jynik/meta-owswaas/README

This is the meta-owswaas Yocto layer, which implements 
Owen Wilson Saying "Wow" as a Service (OWSWaaS).

You can see a demo of it here:
https://twitter.com/utkan0s/status/953669143177424897

This layer currently targets the Raspberry Pi Zero (W), but can easily be adapted
to other platforms. To start, you'll need to add a BTN_GPIO definition in
init-owswaas.bb. You may also need to tweak the alsa-state.bbappend.

If you haven't used Yocto before, you can find a quick intro here:
https://github.com/jynik/ready-set-yocto

Dependencies
============

This layer depends on:

  URI: git://git.yoctoproject.org/poky.git
  layers: meta, meta-poky
  branch: zeus

  URI: https://github.com/agherzan/meta-raspberrypi.git
  layers: meta-raspberrypi
  branch: zeus

  URL: git://git.openembedded.org/meta-openembedded
  layers: meta-oe, meta-multimedia, meta-networking, meta-python, meta-filesystems
  branch: zeus

Patches
=======

Please submit patches as pull requests on Github at:
https://github.com/jynik/meta-owswaas/pulls

Hardware
========

This is a fairly simple setup, and makes for a fun beginner/intermediate hobbyist
electronics project. Information about the hardware components can be found here:

* [Schematic][./doc/owswaas-shield.pdf]
* [Bill of Materials](./doc/BOM.md)
