jynik/meta-owswaas/doc/images/README.md

### OWSWaaS "shield", sans 220 uF bulk capacitor

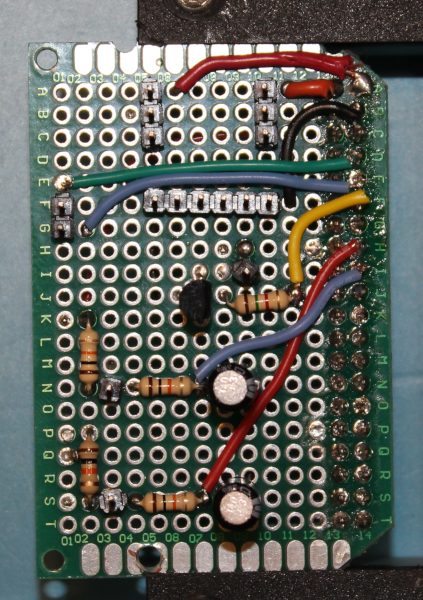
[picture p3: doc/images/shield_top_sans_bulk_cap.png]
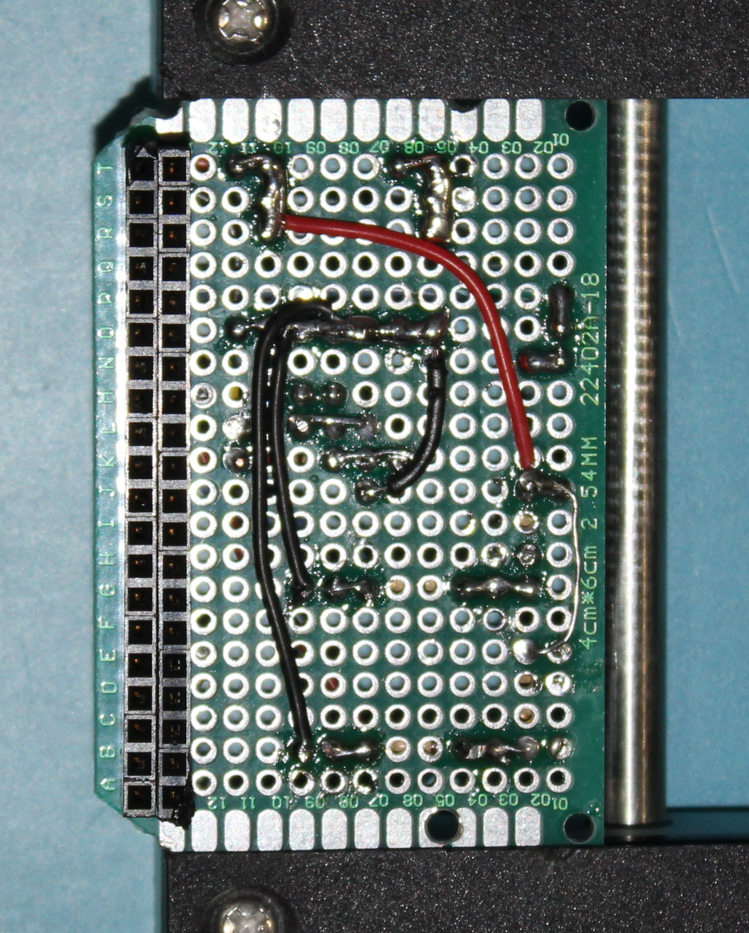
[picture p4: doc/images/shield_bot_sans_bulk_cap.png]


See [owswaas-shield.pdf](../kicad/owswaas-shield.pdf) for the schematic.

### Retrofitting 5 "super bright" LEDs into button dome

Not shown: Replacing the plastic diffuser with one made out of hot glue and green transparent filter paper.



### Testing everything prior to closing it all up

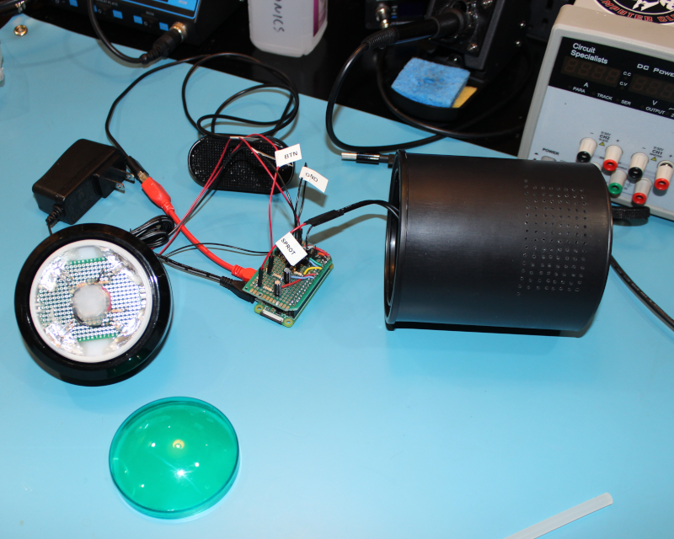
[picture p5: doc/images/assembly-01.png]


### Installing jumpers

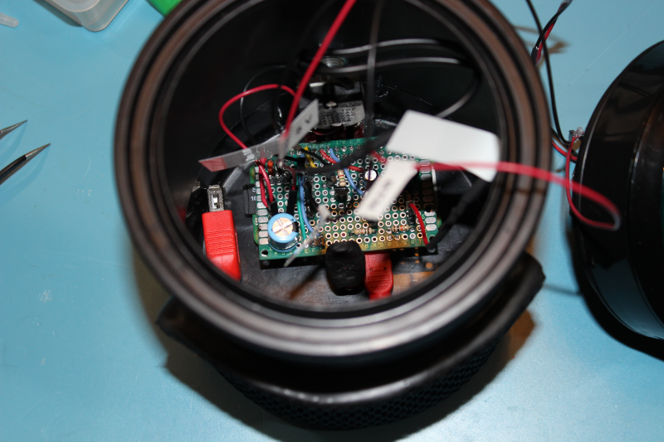
[picture p6: doc/images/assembly-02.png]


### Velcro'ing USB speaker into place

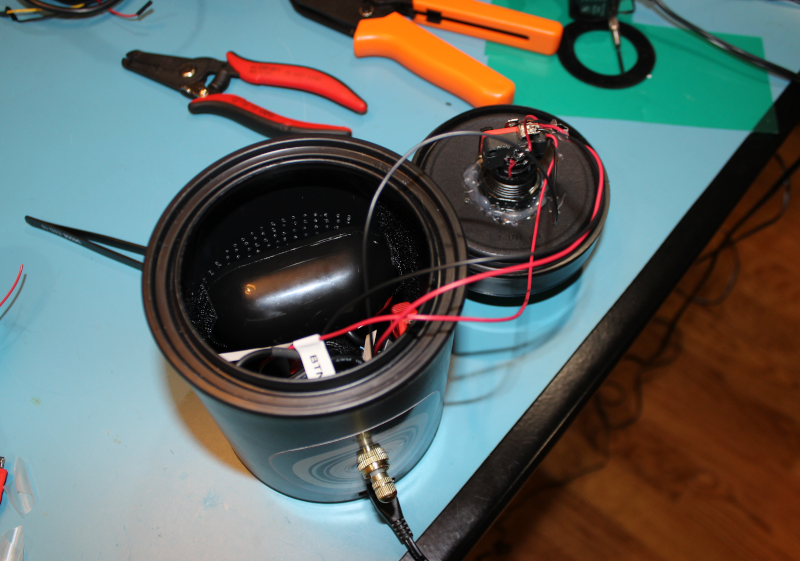
[picture p7: doc/images/assembly-03.png]


### Assembled device, faux speaker front



### Assembled device, rotary switch and USB micro power 
