jynik/meta-owswaas/doc/images/owswaas-jumper-pos.png

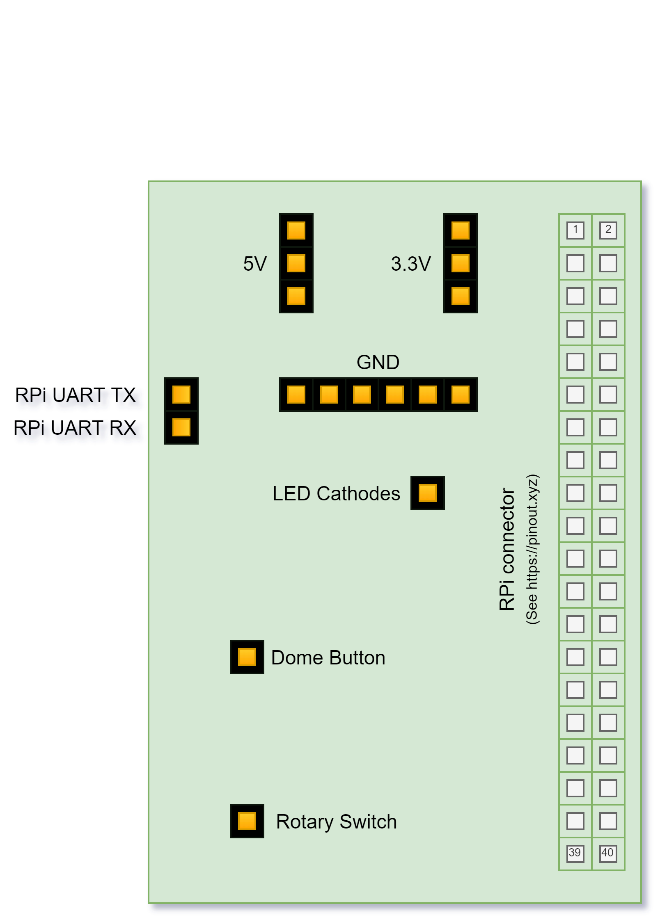
doc/images/owswaas-jumper-pos.png
