jynik/meta-owswaas/doc/kicad/owswaas-shield.pdf

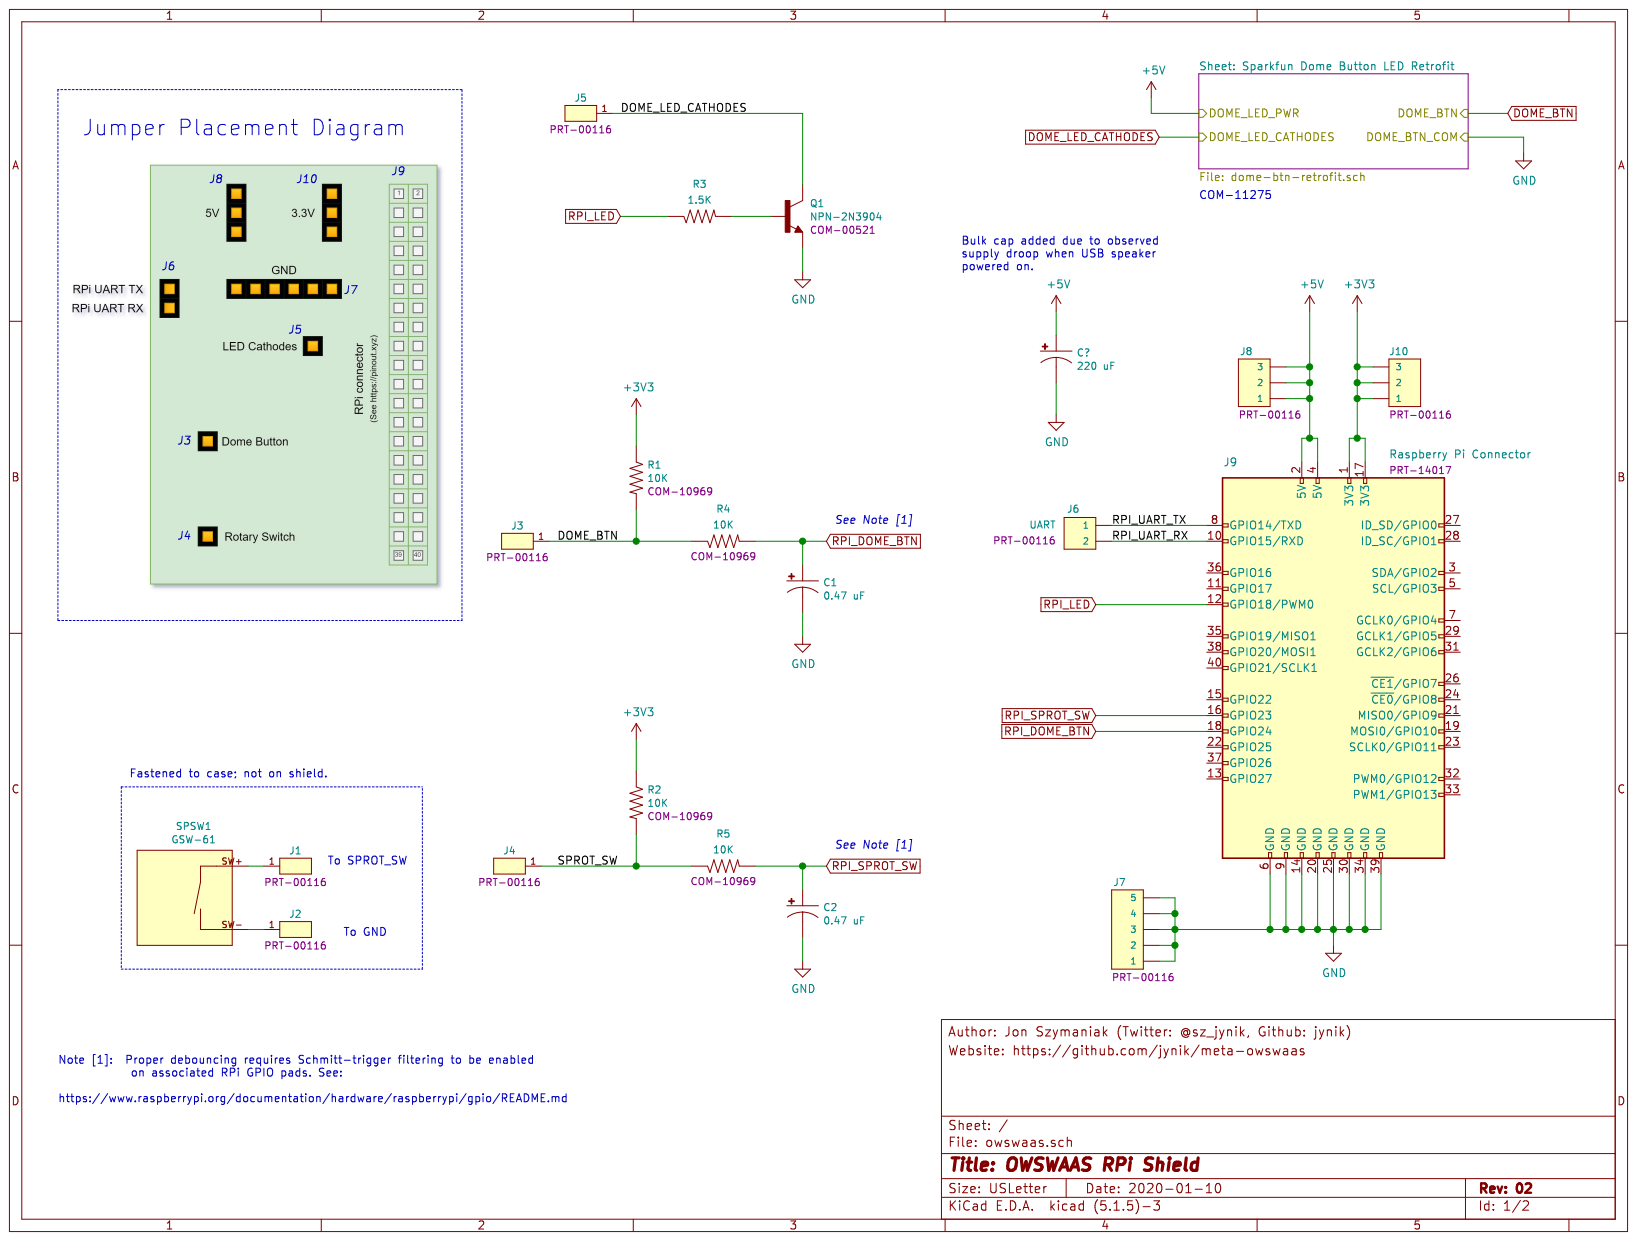
[picture p9: page 1]

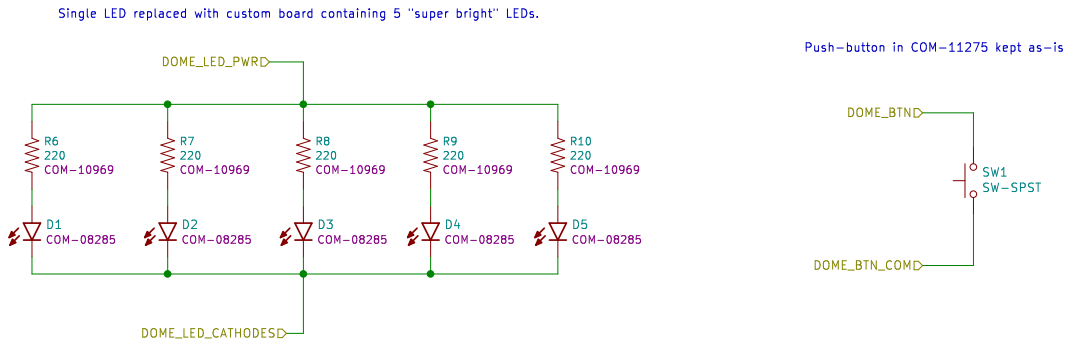
[picture p10: page 2]
