jynik/meta-owswaas/doc/kicad/dome-btn-retrofit.sch

## KiCad design doc/kicad/dome-btn-retrofit.sch (2020-01-23)

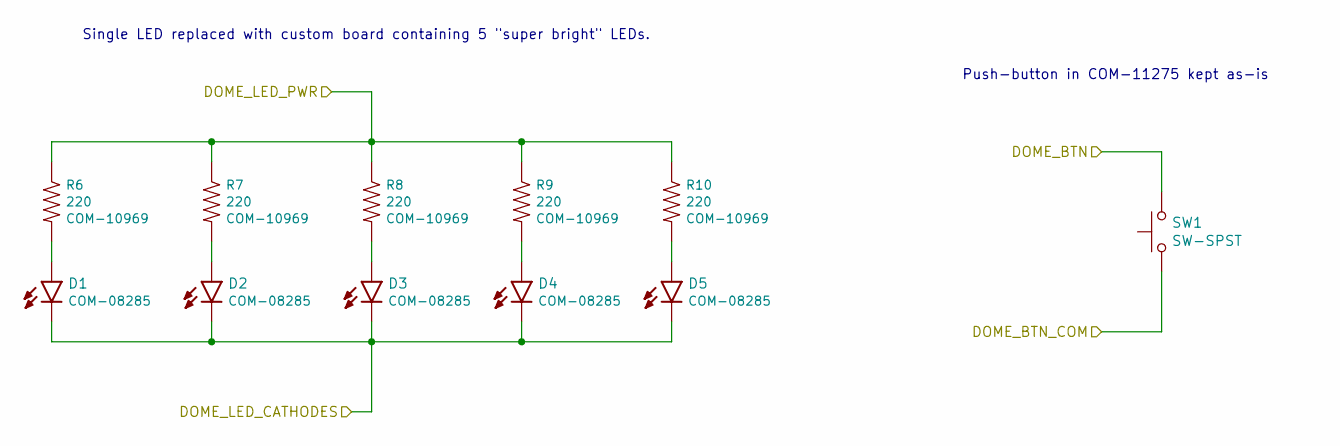
[picture p11: schematic dome-btn-retrofit.sch]

Parts:
D1, D2, D3, D4, D5: SPARKFUN-LED_LED-GREEN-550; LED_550_T1-.75_RT_ANG_PCB
R6, R7, R8, R9, R10: 220
SW1: SW-SPST

Connections:
DOME_BTN: SW1.2
DOME_BTN_COM: SW1.1
DOME_LED_CATHODES: D1.1 (C), D2.1 (C), D3.1 (C), D4.1 (C), D5.1 (C)
DOME_LED_PWR: R6.1, R7.1, R8.1, R9.1, R10.1
unnamed: D1.2 (A), R6.2
unnamed: D2.2 (A), R7.2
unnamed: D3.2 (A), R8.2
unnamed: D4.2 (A), R9.2
unnamed: D5.2 (A), R10.2

Notes on the sheet:
Single LED replaced with custom board containing 5 "super bright" LEDs.
Push-button in COM-11275 kept as-is
