jynik/meta-owswaas/doc/kicad/owswaas.sch

## KiCad design doc/kicad/owswaas.sch (2020-01-23)

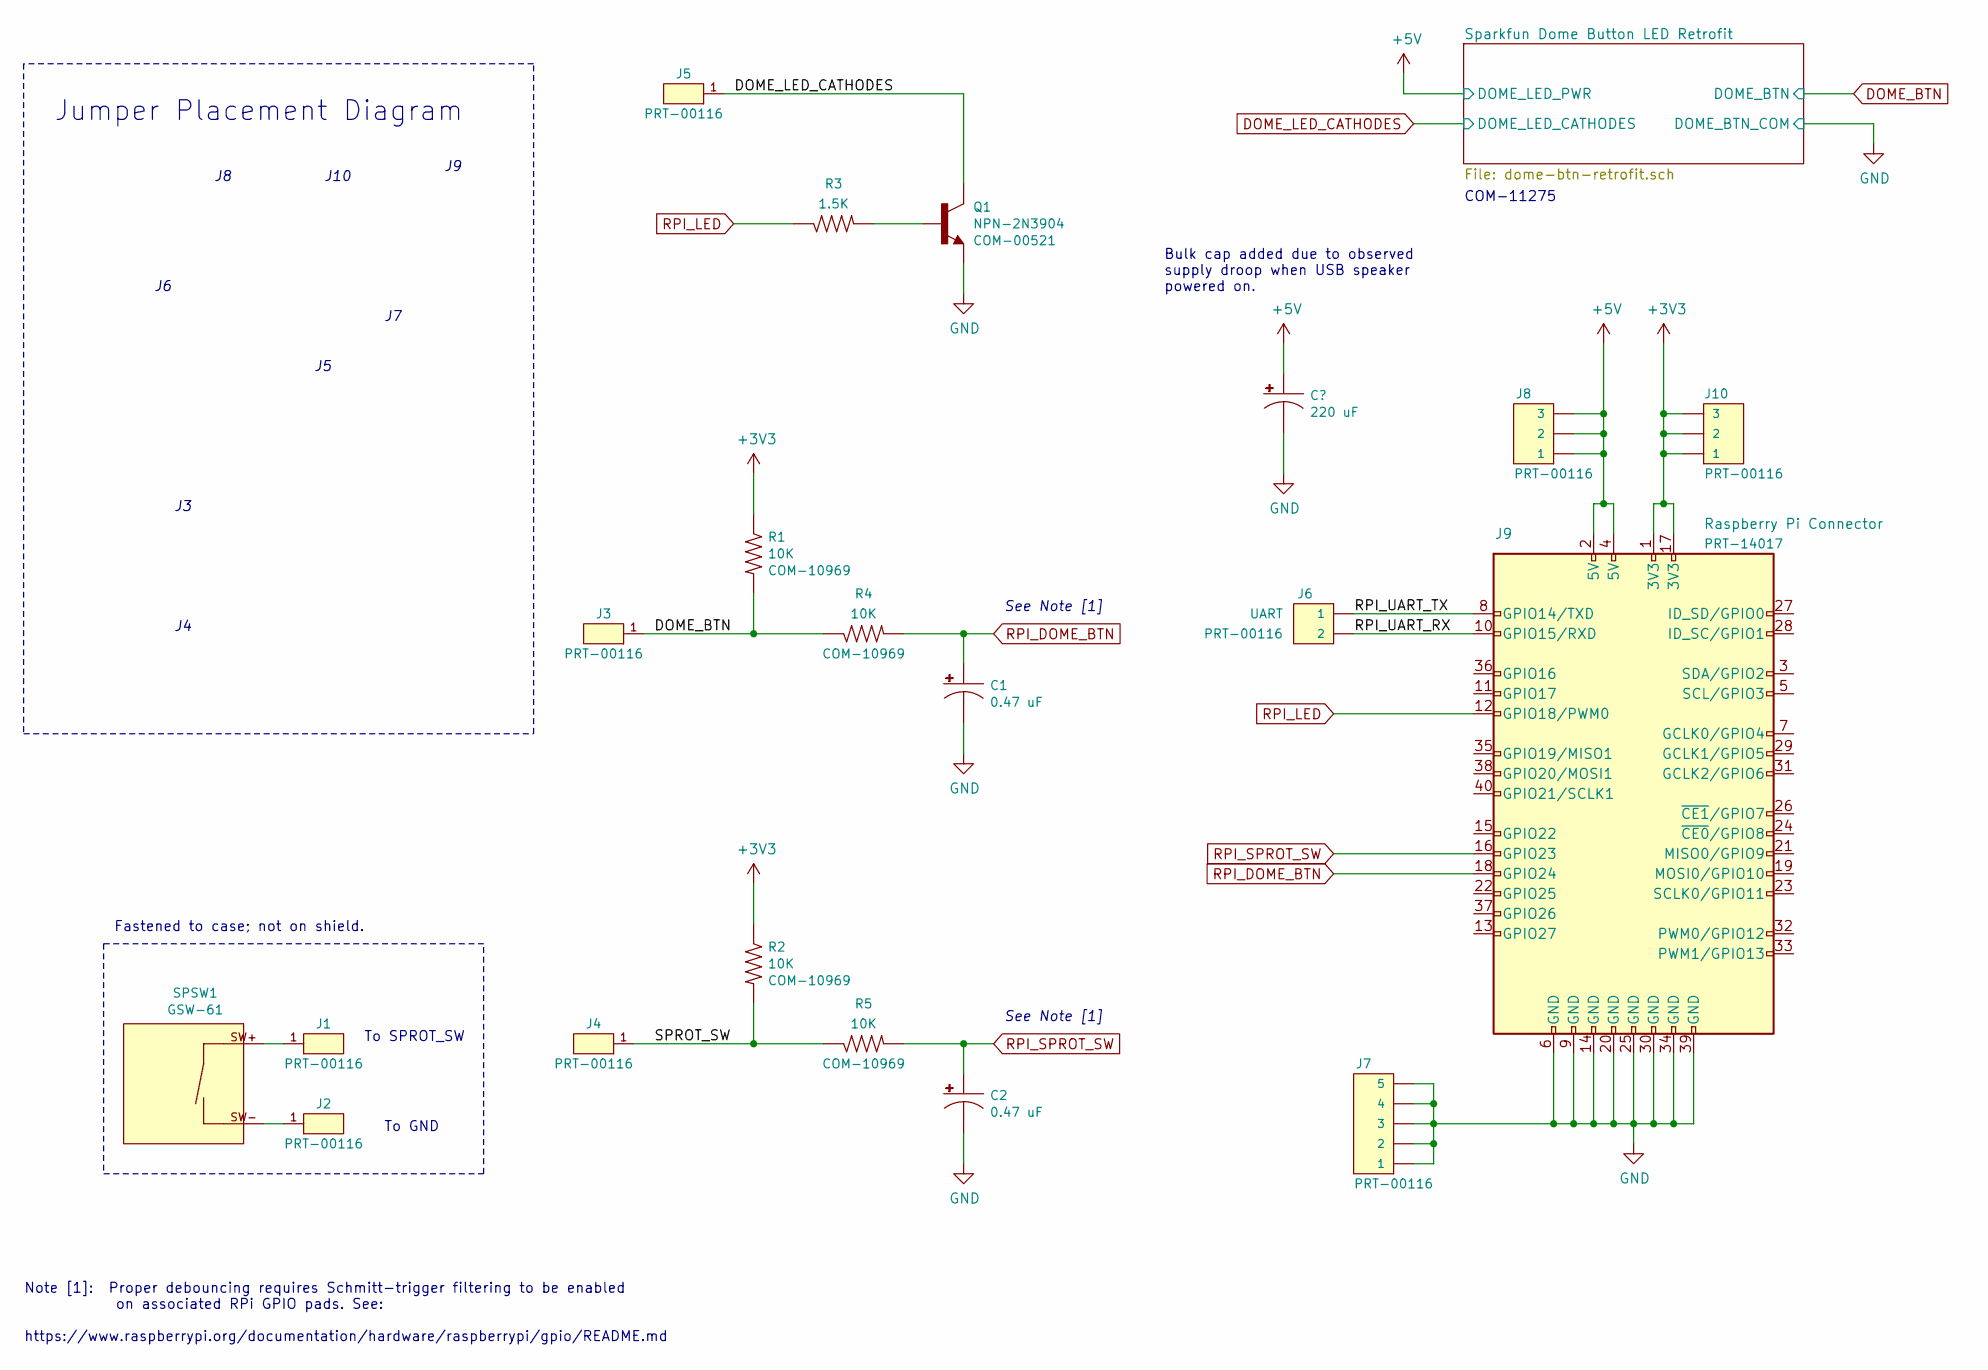
[picture p12: schematic owswaas.sch]

Parts:
C1, C2: 0.47 uF; EIA3528
J1, J2, J3, J4, J5: RPI_LED_CATH_JMP
J6: UART; 1X02
J7: GND_JMP; 1X05
J8: 5V_JMP; 1X03
J9: Raspberry Pi Connector
J10: 3V3_JMP; 1X03
Q1: NPN-2N3904; TO-92
R1, R2, R4, R5: 10K; AXIAL-0.3-KIT
R3: 1.5K
SPSW1: GSW-61; ROTARY_ENC_PLAIN

Connections:
+3V3: J9.1 (3V3), J9.17 (3V3), J10.1, J10.2, J10.3, R1.P$1 (1), R2.P$1 (1)
+5V: J8.1, J8.2, J8.3, J9.2 (5V), J9.4 (5V)
DOME_BTN: J3.1, R1.P$2 (2), R4.P$1 (1)
DOME_LED_CATHODES: J5.1, Q1.3 (C)
GND: C1.C (-), C2.C (-), J7.1, J7.2, J7.3, J7.4, J7.5, J9.6 (GND), J9.9 (GND), J9.14 (GND), J9.20 (GND), J9.25 (GND), J9.30 (GND), J9.34 (GND), J9.39 (GND), Q1.1 (E)
unnamed: J1.1, SPSW1.SW+
unnamed: J2.1, SPSW1.SW-
unnamed: Q1.2 (B), R3.2
RPI_DOME_BTN: C1.A (+), J9.18 (GPIO24), R4.P$2 (2)
RPI_LED: J9.12 (GPIO18/PWM0), R3.1
RPI_SPROT_SW: C2.A (+), J9.16 (GPIO23), R5.P$2 (2)
RPI_UART_RX: J6.2, J9.10 (GPIO15/RXD)
RPI_UART_TX: J6.1, J9.8 (GPIO14/TXD)
SPROT_SW: J4.1, R2.P$2 (2), R5.P$1 (1)

Notes on the sheet:
Note [1]: Proper debouncing requires Schmitt-trigger filtering to be enabled on associated RPi GPIO pads. See: https://www.raspberrypi.org/documentation/hardware/raspberrypi/gpio/README.md
COM-11275
Fastened to case; not on shield.
To SPROT_SW
To GND
Jumper Placement Diagram
See Note [1]
J10
Bulk cap added due to observed supply droop when USB speaker powered on.
