jynik/meta-owswaas/(commit log)

2020-01-23 doc: Added documentation for new device build
    Moving forward, this is the hardware targeted by this layer.
    [dome-btn-retrofit.sch, owswaas.sch]
2020-01-23 audio-samples: Renamed recipe and install directory, new samples
    Per request, and against my better judgement, added
    David Lee Roth samples.
    Thanks, I hate it.
2020-01-23 rpi-config: Remove Speaker pHAT configuration
    The Speaker pHAT was too quiet and presents an annoying issue
    where the DAC clock starts before audio samples are delivered,
    resulting a "pop" sound when each clip starts.
    (Apparently Pimoroni has fixed this in later revisions.)
    Thus, I've opted to go with a cheap little USB speaker.
2020-01-23 doc: Added hardware images
    *gasp* Committing binary data to git? Heathen!
2020-01-23 doc/BOM: Added bulk supply cap, speaker fabric, sugru/velcro notes
2020-01-23 README: Added images to the device
2020-01-23 doc/images: Added README.md as a "landing page"
2020-01-23 Removed samples/
    I'd prefer folks actually just use the tools to create their local.conf
    and bblayer.conf, rather than maintaining copy-pasta examples...
2020-01-24 README: Fixed link to schematic
2020-01-27 audio-samples: Added movie and "Malort Commercial" quotes
2020-02-07 alsa-state: Update asound.conf device name
    As it turns out, '!default' is exectly the value I didn't want.
    Provide this with a more appropriate name so that amixer operates as
    desired.
2020-02-07 owswaas-daemon: Configure button for either edge
    This will enable the press-timing for v0.3 of the owswaas program.
2022-03-31 doc/README.md: Add schematic link
